WarriorOx/NumM_Pad/Business Card-01.png

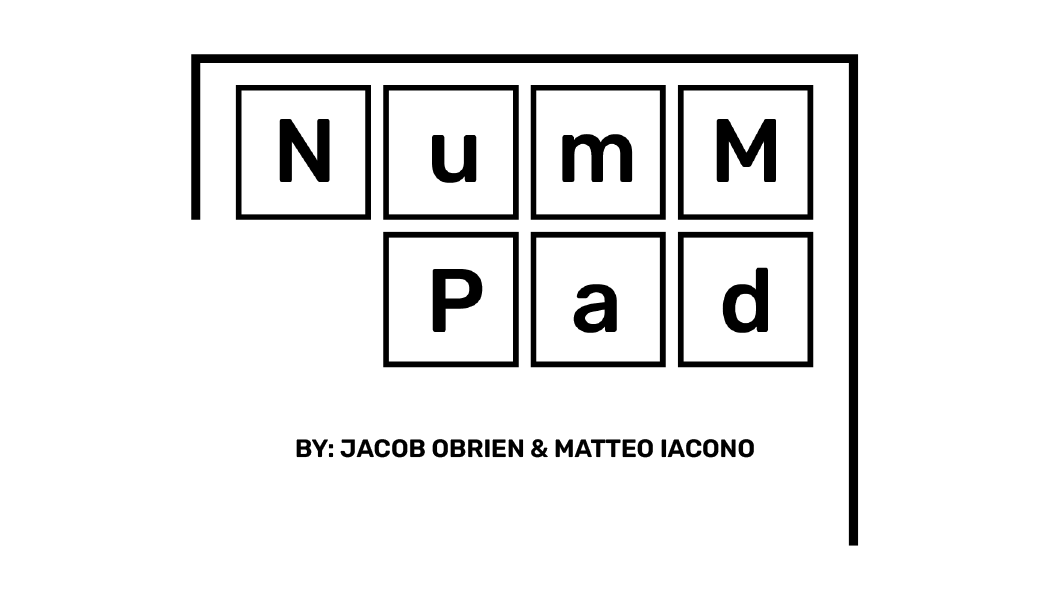
Business Card-01.png
