WarriorOx/NumM_Pad/Business Card-02.png

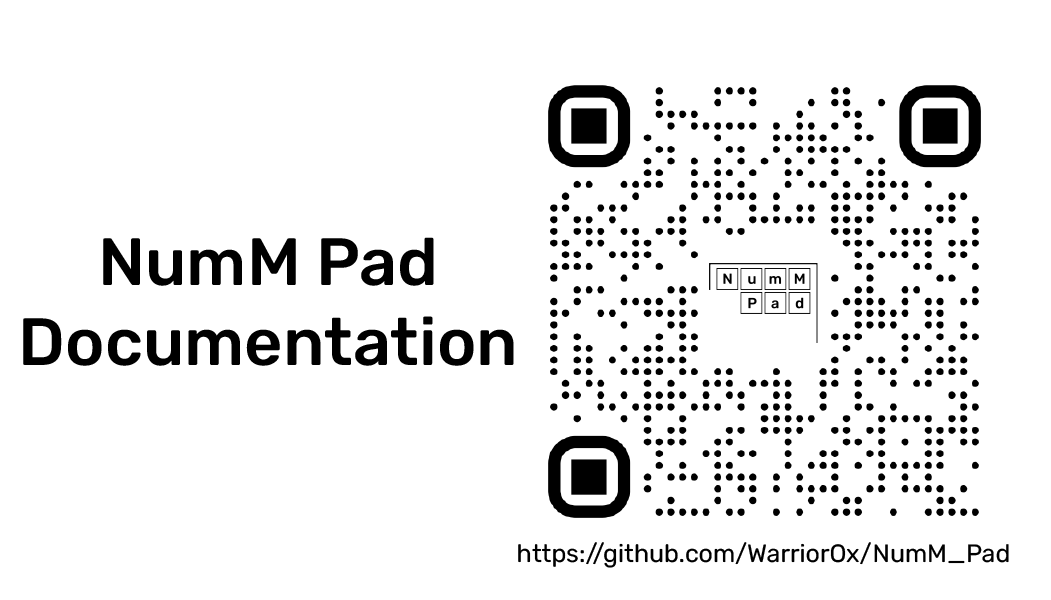
Business Card-02.png
