WarriorOx/NumM_Pad/3D Models/Encoder Knob.stl

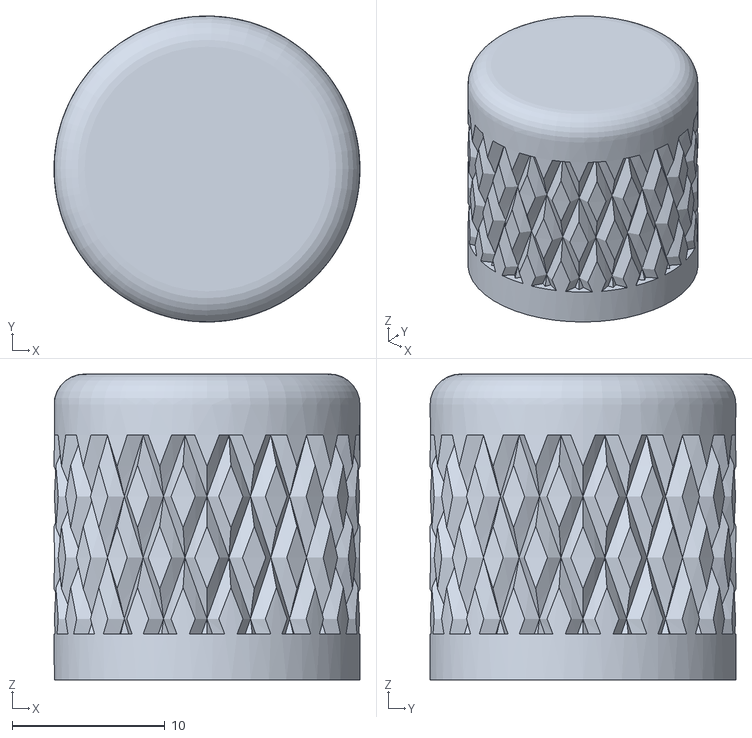
[picture p16: CAD file, 2023-03-14]
3D Models/Encoder Knob.stl
20.0 x 20.0 x 20.0
